selim-drone-proj/fire_detect/hardware/case/drawings/out/png/ESS01-CASE-01_제어함본체.png

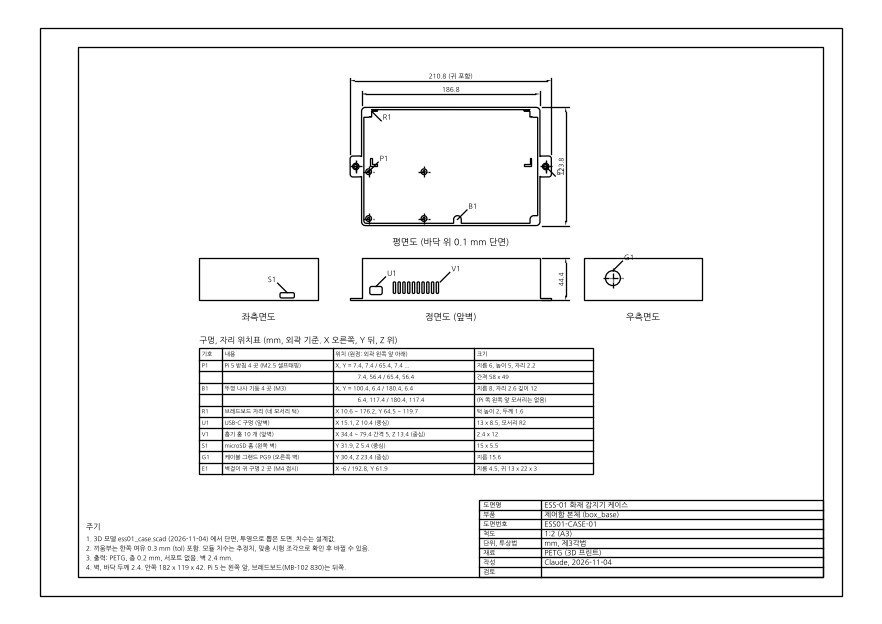
hardware/case/drawings/out/png/ESS01-CASE-01_제어함본체.png
