selim-drone-proj/fire_detect/hardware/case/drawings/out/png/ESS01-CASE-02_제어함뚜껑.png

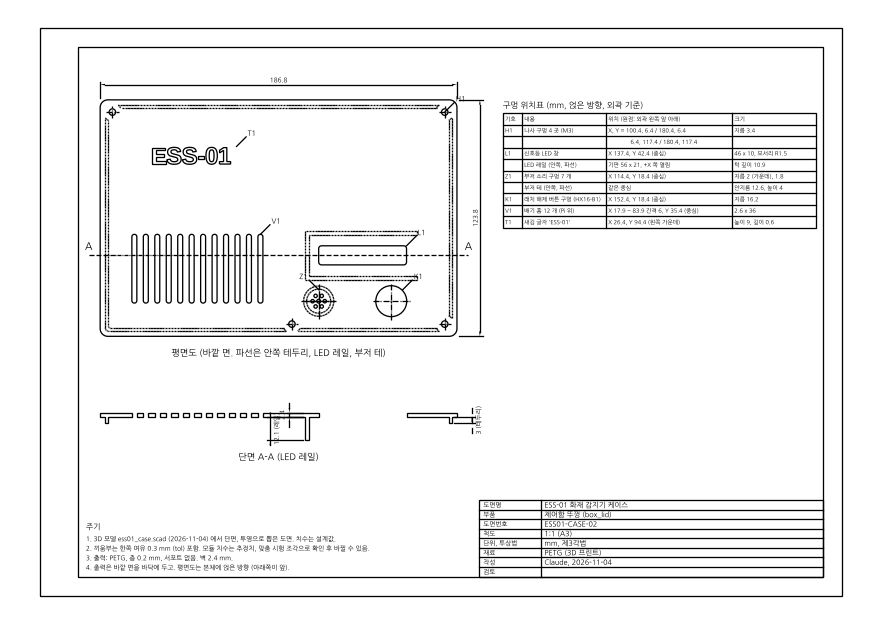
hardware/case/drawings/out/png/ESS01-CASE-02_제어함뚜껑.png
