selim-drone-proj/fire_detect/hardware/case/drawings/out/png/ESS01-CASE-03_센서헤드본체.png

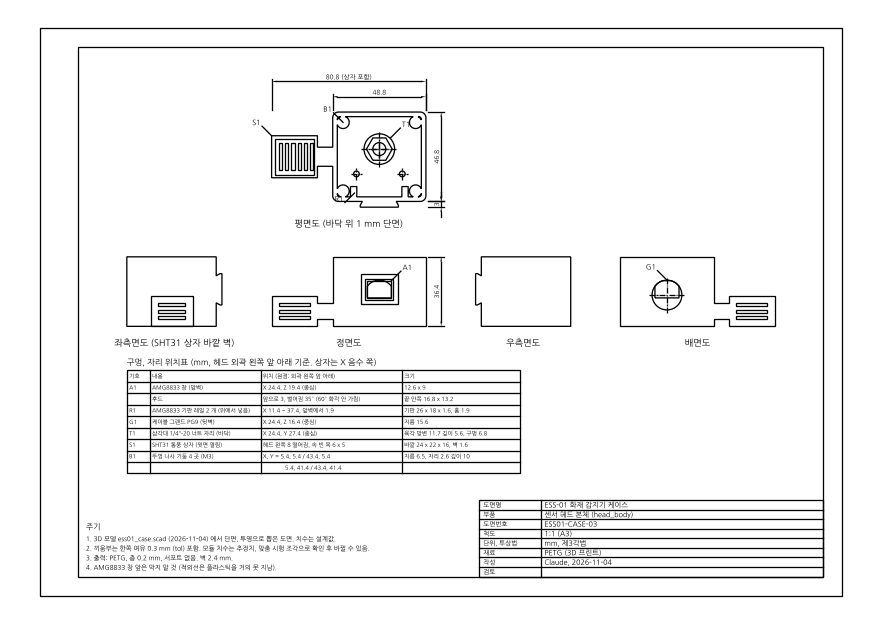
hardware/case/drawings/out/png/ESS01-CASE-03_센서헤드본체.png
