selim-drone-proj/fire_detect/hardware/case/png/base_front.png

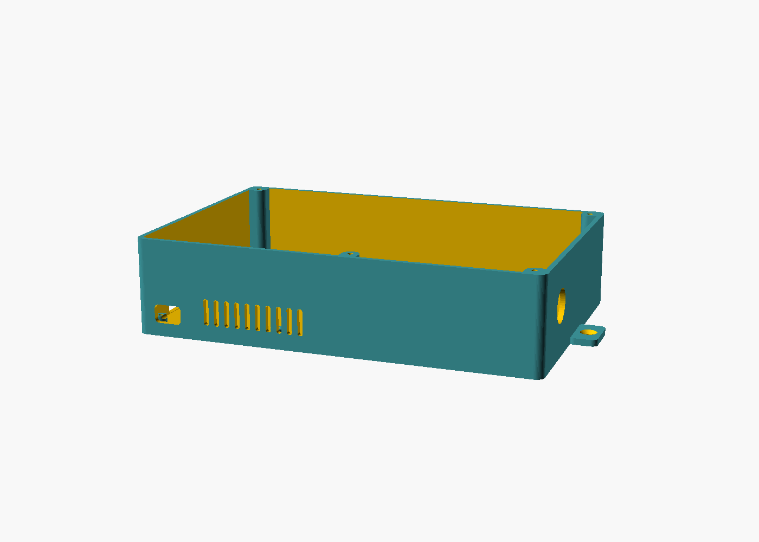
hardware/case/png/base_front.png
