selim-drone-proj/fire_detect/hardware/case/png/base_top.png

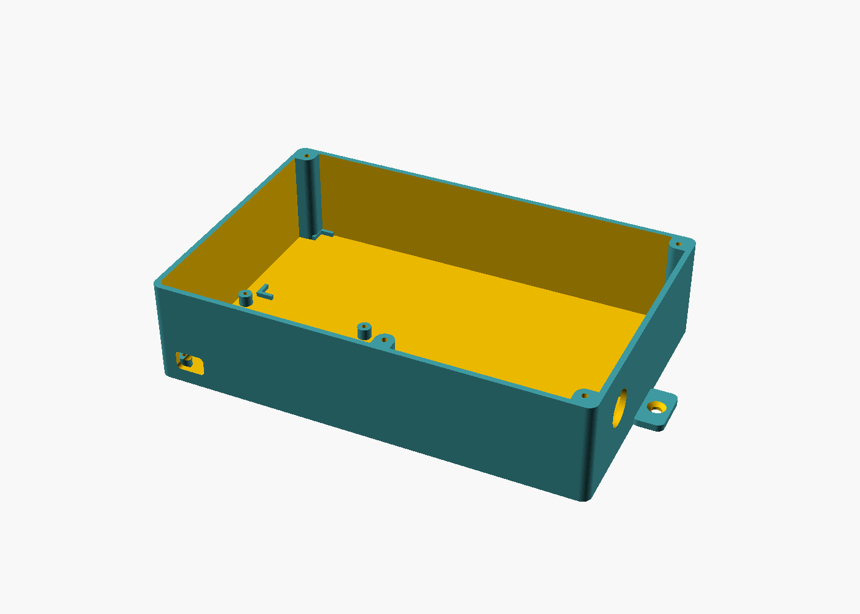
hardware/case/png/base_top.png
