selim-drone-proj/fire_detect/hardware/case/png/head_front.png

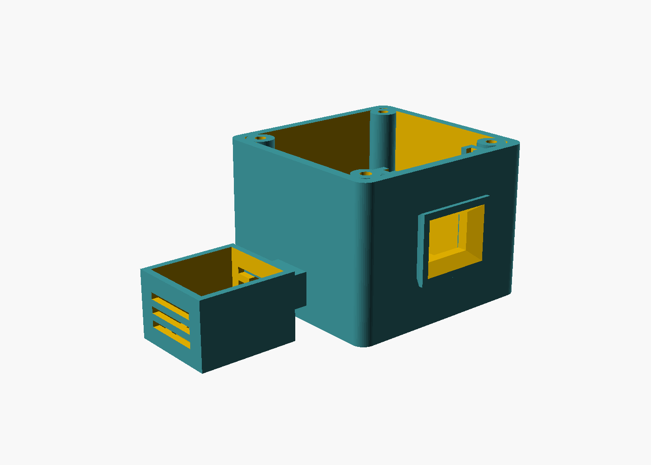
hardware/case/png/head_front.png
