selim-drone-proj/fire_detect/hardware/case/png/head_pod.png

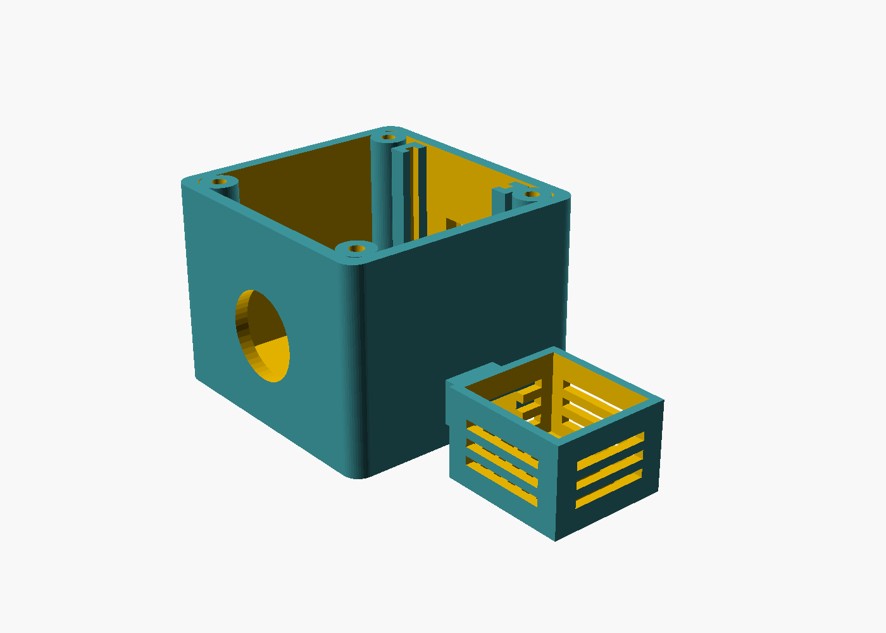
hardware/case/png/head_pod.png
