selim-drone-proj/fire_detect/hardware/case/drawings/out/ESS01-CASE-03_센서헤드본체.dxf

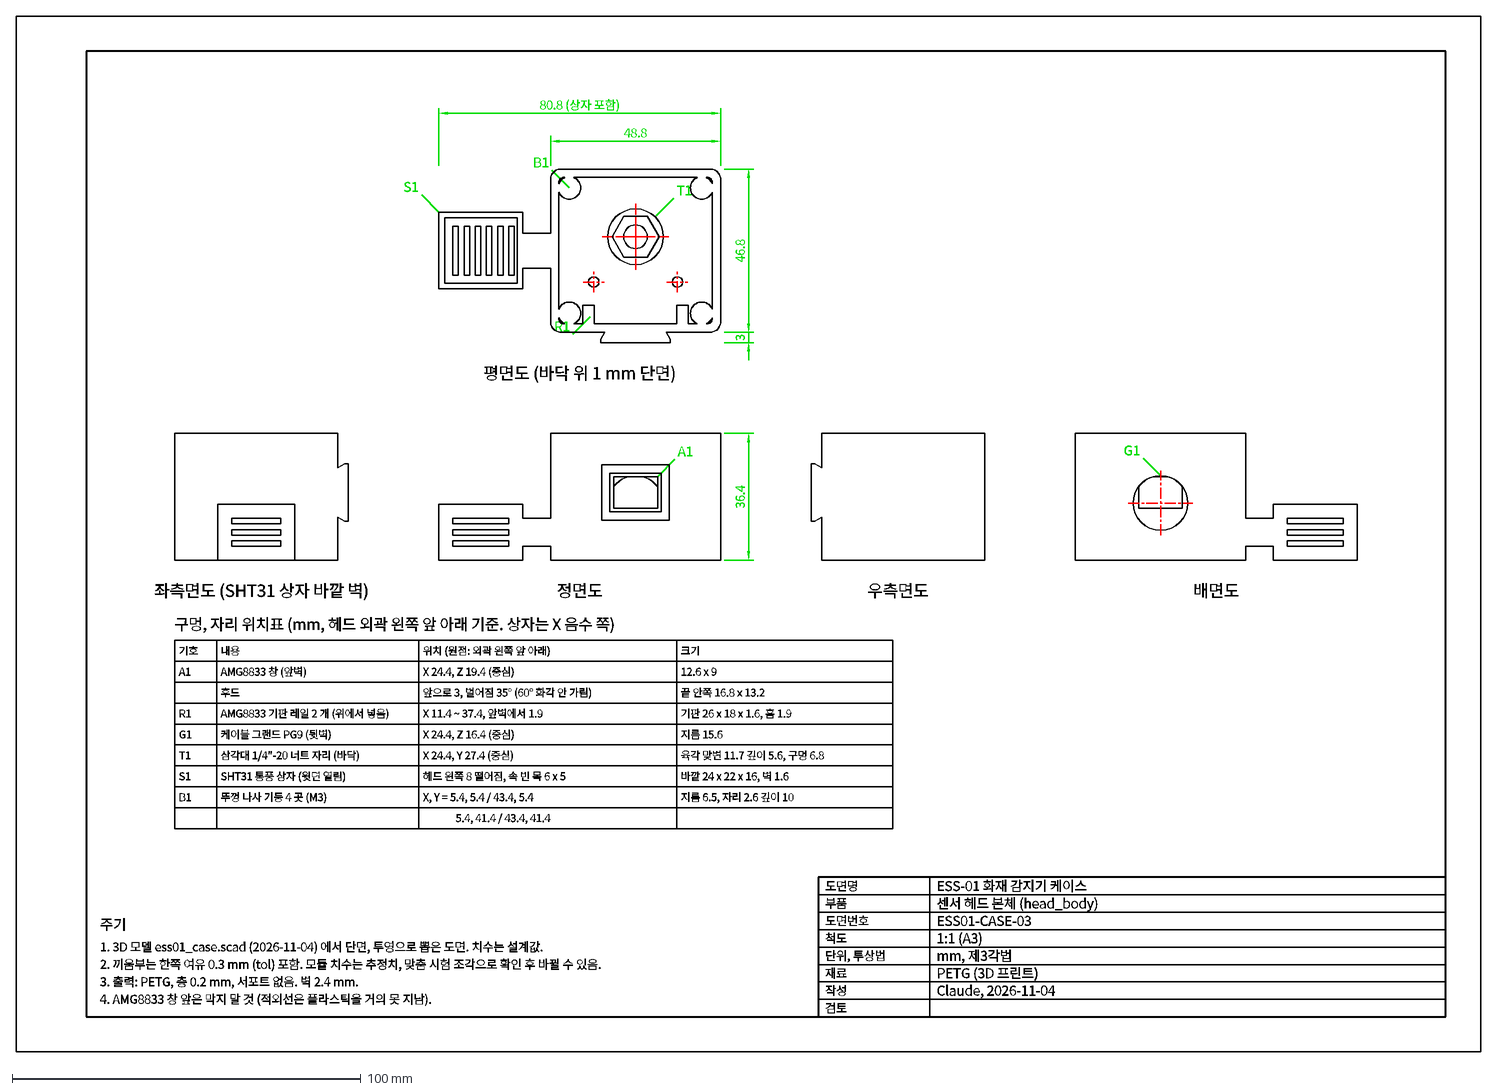
[picture p8: CAD file, 2026-11-07]
hardware/case/drawings/out/ESS01-CASE-03_센서헤드본체.dxf
80.8 (상자 포함)
48.8
46.8
3
36.4
A1
G1
T1
S1
B1
R1
평면도 (바닥 위 1 mm 단면)
정면도
우측면도
좌측면도 (SHT31 상자 바깥 벽)
배면도
구멍, 자리 위치표 (mm, 헤드 외곽 왼쪽 앞 아래 기준. 상자는 X 음수 쪽)
기호
내용
위치 (원점: 외곽 왼쪽 앞 아래)
크기
AMG8833 창 (앞벽)
X 24.4, Z 19.4 (중심)
12.6 x 9
후드
앞으로 3, 벌어짐 35° (60° 화각 안 가림)
끝 안쪽 16.8 x 13.2
AMG8833 기판 레일 2 개 (위에서 넣음)
X 11.4 ~ 37.4, 앞벽에서 1.9
기판 26 x 18 x 1.6, 홈 1.9
케이블 그랜드 PG9 (뒷벽)
X 24.4, Z 16.4 (중심)
지름 15.6
삼각대 1/4"-20 너트 자리 (바닥)
X 24.4, Y 27.4 (중심)
육각 맞변 11.7 깊이 5.6, 구멍 6.8
SHT31 통풍 상자 (윗면 열림)
헤드 왼쪽 8 떨어짐, 속 빈 목 6 x 5
바깥 24 x 22 x 16, 벽 1.6
뚜껑 나사 기둥 4 곳 (M3)
X, Y = 5.4, 5.4 / 43.4, 5.4
지름 6.5, 자리 2.6 깊이 10
5.4, 41.4 / 43.4, 41.4
검토
작성
Claude, 2026-11-04
재료
PETG (3D 프린트)
단위, 투상법
mm, 제3각법
척도
1:1 (A3)
도면번호
ESS01-CASE-03
부품
센서 헤드 본체 (head_body)
도면명
ESS-01 화재 감지기 케이스
4. AMG8833 창 앞은 막지 말 것 (적외선은 플라스틱을 거의 못 지남).
3. 출력: PETG, 층 0.2 mm, 서포트 없음. 벽 2.4 mm.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
