selim-drone-proj/fire_detect/hardware/case/drawings/out/ESS01-CASE-01_제어함본체.dxf

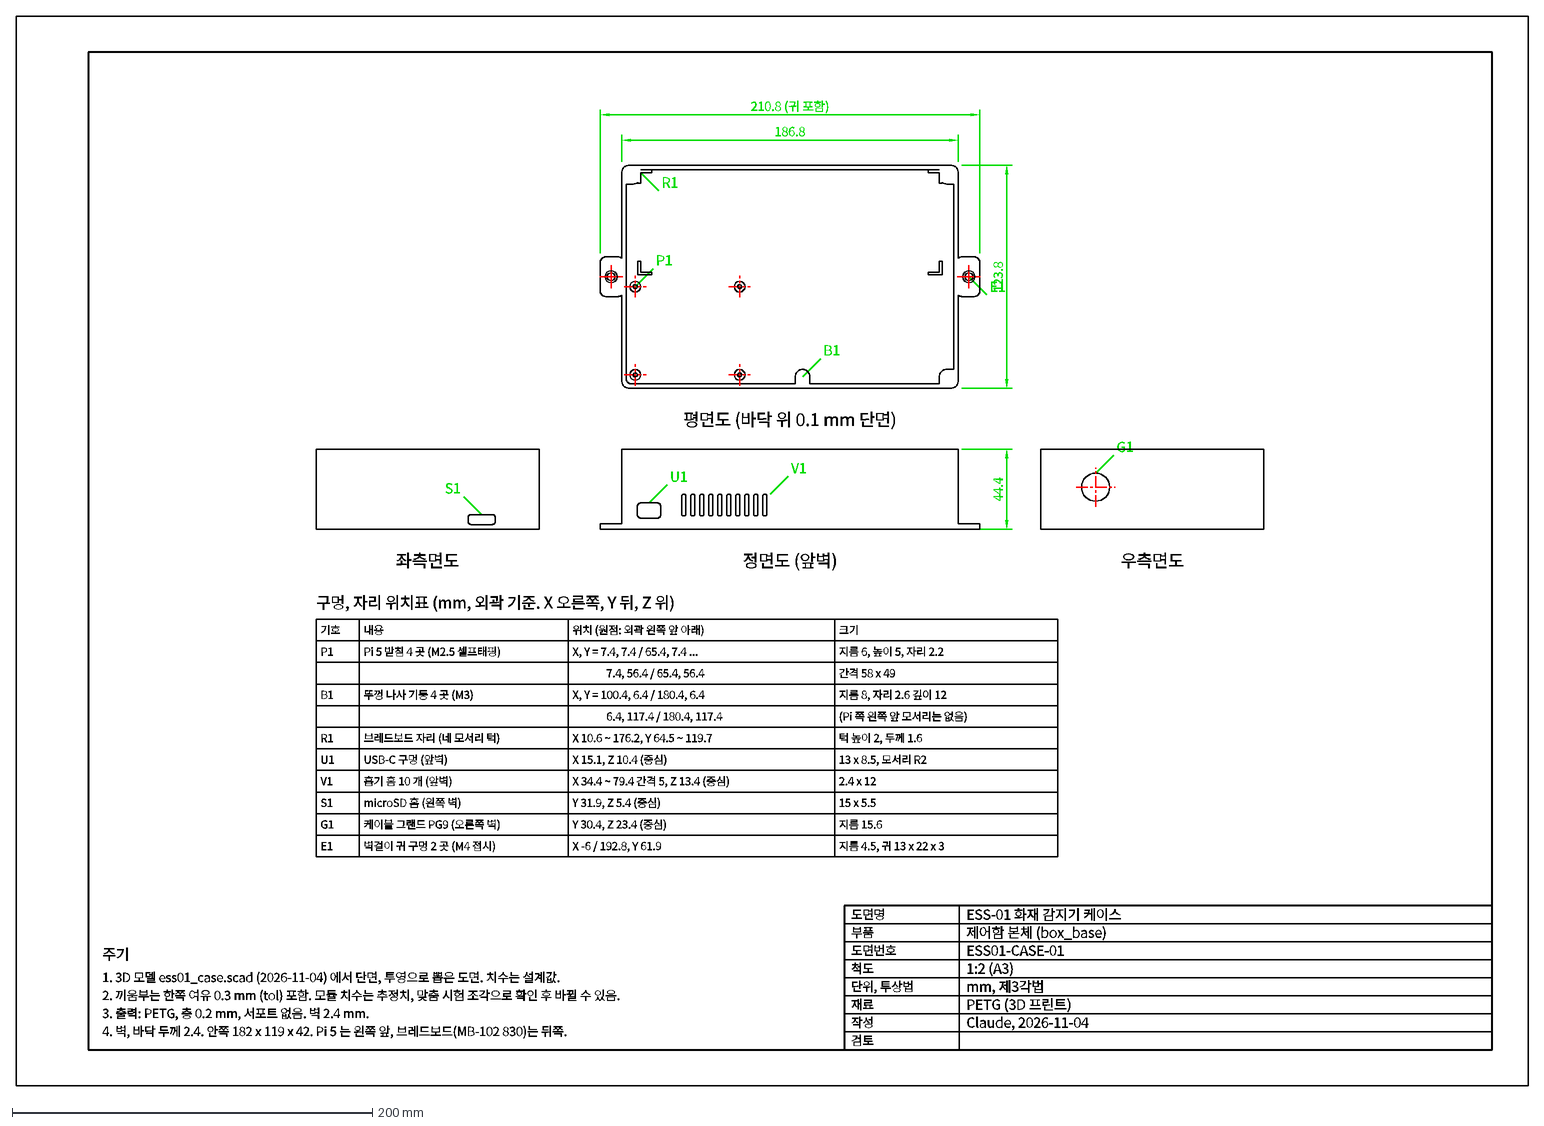
[picture p9: CAD file, 2026-11-07]
hardware/case/drawings/out/ESS01-CASE-01_제어함본체.dxf
186.8
210.8 (귀 포함)
123.8
44.4
P1
B1
R1
E1
U1
V1
S1
G1
평면도 (바닥 위 0.1 mm 단면)
정면도 (앞벽)
우측면도
좌측면도
구멍, 자리 위치표 (mm, 외곽 기준. X 오른쪽, Y 뒤, Z 위)
기호
내용
위치 (원점: 외곽 왼쪽 앞 아래)
크기
Pi 5 받침 4 곳 (M2.5 셀프태핑)
X, Y = 7.4, 7.4 / 65.4, 7.4 ...
지름 6, 높이 5, 자리 2.2
7.4, 56.4 / 65.4, 56.4
간격 58 x 49
뚜껑 나사 기둥 4 곳 (M3)
X, Y = 100.4, 6.4 / 180.4, 6.4
지름 8, 자리 2.6 깊이 12
6.4, 117.4 / 180.4, 117.4
(Pi 쪽 왼쪽 앞 모서리는 없음)
브레드보드 자리 (네 모서리 턱)
X 10.6 ~ 176.2, Y 64.5 ~ 119.7
턱 높이 2, 두께 1.6
USB-C 구멍 (앞벽)
X 15.1, Z 10.4 (중심)
13 x 8.5, 모서리 R2
흡기 홈 10 개 (앞벽)
X 34.4 ~ 79.4 간격 5, Z 13.4 (중심)
2.4 x 12
microSD 홈 (왼쪽 벽)
Y 31.9, Z 5.4 (중심)
15 x 5.5
케이블 그랜드 PG9 (오른쪽 벽)
Y 30.4, Z 23.4 (중심)
지름 15.6
벽걸이 귀 구멍 2 곳 (M4 접시)
X -6 / 192.8, Y 61.9
지름 4.5, 귀 13 x 22 x 3
검토
작성
Claude, 2026-11-04
재료
PETG (3D 프린트)
단위, 투상법
mm, 제3각법
척도
1:2 (A3)
도면번호
ESS01-CASE-01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
