selim-drone-proj/fire_detect/hardware/case/drawings/out/ESS01-CASE-02_제어함뚜껑.dxf

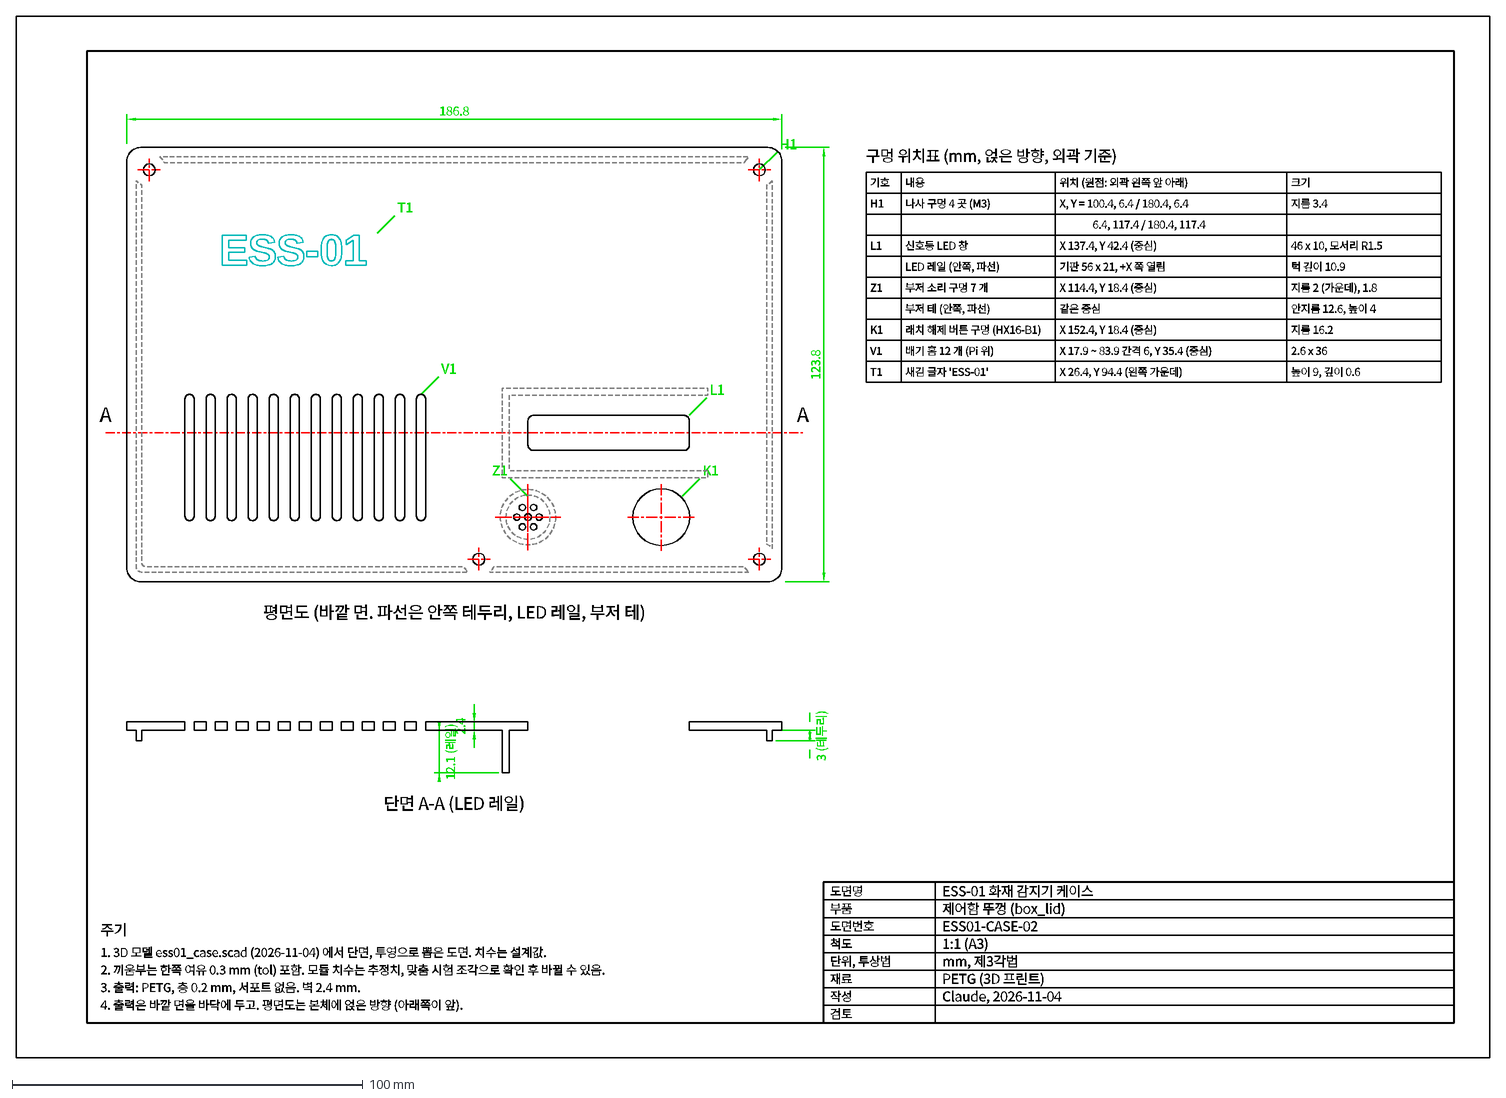
[picture p10: CAD file, 2026-11-07]
hardware/case/drawings/out/ESS01-CASE-02_제어함뚜껑.dxf
A
186.8
123.8
2.4
12.1 (레일)
3 (테두리)
H1
L1
Z1
K1
V1
T1
평면도 (바깥 면. 파선은 안쪽 테두리, LED 레일, 부저 테)
단면 A-A (LED 레일)
구멍 위치표 (mm, 얹은 방향, 외곽 기준)
기호
내용
위치 (원점: 외곽 왼쪽 앞 아래)
크기
나사 구멍 4 곳 (M3)
X, Y = 100.4, 6.4 / 180.4, 6.4
지름 3.4
6.4, 117.4 / 180.4, 117.4
신호등 LED 창
X 137.4, Y 42.4 (중심)
46 x 10, 모서리 R1.5
LED 레일 (안쪽, 파선)
기판 56 x 21, +X 쪽 열림
턱 깊이 10.9
부저 소리 구멍 7 개
X 114.4, Y 18.4 (중심)
지름 2 (가운데), 1.8
부저 테 (안쪽, 파선)
같은 중심
안지름 12.6, 높이 4
래치 해제 버튼 구멍 (HX16-B1)
X 152.4, Y 18.4 (중심)
지름 16.2
배기 홈 12 개 (Pi 위)
X 17.9 ~ 83.9 간격 6, Y 35.4 (중심)
2.6 x 36
새김 글자 'ESS-01'
X 26.4, Y 94.4 (왼쪽 가운데)
높이 9, 깊이 0.6
검토
작성
Claude, 2026-11-04
재료
PETG (3D 프린트)
단위, 투상법
mm, 제3각법
척도
1:1 (A3)
도면번호
ESS01-CASE-02
부품
제어함 뚜껑 (box_lid)
도면명
ESS-01 화재 감지기 케이스
4. 출력은 바깥 면을 바닥에 두고. 평면도는 본체에 얹은 방향 (아래쪽이 앞).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
