selim-drone-proj/fire_detect/hardware/case/png/assembly_top.png

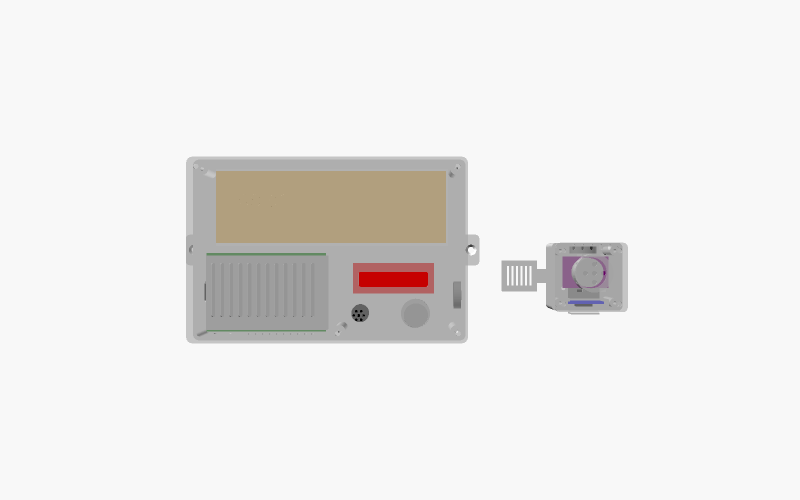
hardware/case/png/assembly_top.png
