selim-drone-proj/fire_detect/hardware/case/png/fit_test.png

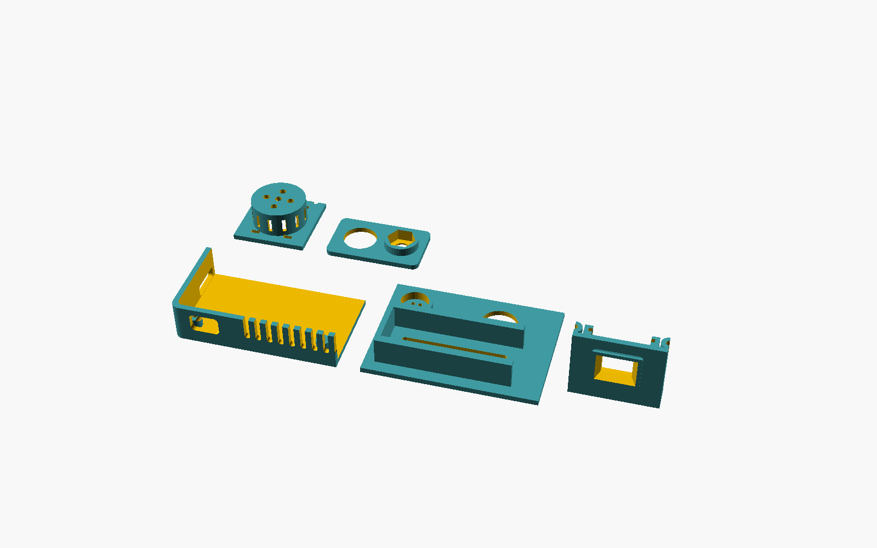
hardware/case/png/fit_test.png
