selim-drone-proj/fire_detect/(commit log)

2026-10-10 화재 감지기 (ess_01) 소프트웨어 첫 업로드
    - fire_detect: AMG8833 열화상, SHT31 주변 온도, MQ-2 연기 (ADS1115) 로 1초마다 판정
    - 위험하면 SSR 과 릴레이로 충전 차단, 부저와 신호등 LED, OLED 표시
    - 기록: fire, thermal CSV 와 규격 v0.2 JSONL, 선택적으로 ROS 2 전송
    - systemd 서비스 (watchdog), 하드웨어 없이 도는 시뮬레이션 (--simulate)
    - 시험: 24 통과
    Claude-Session: https://claude.ai/code/session_012wNjCpgR12iZANsGPh38N5
2026-10-10 LICENSE 추가 (Apache-2.0, moving-ver 와 stable-ver 와 같은 문서)
    pyproject.toml 의 license 표기와 맞춤. 다른 라이선스를 쓸 거면 이 커밋만 빼면 됨.
    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
2026-10-10 보드 세팅용 CLAUDE.md 와 부품 점검 도구 hw_check.py 추가
    - CLAUDE.md: 보드 위 Claude Code 가 따를 안전 규칙(SSR AC 분리 확인 전 출력 시험 금지,
    시스템 파일 변경 전 확인과 .bak, 판정 기준과 watchdog 변경 금지, push 금지 등),
    핀과 주소 표, 14 단계 세팅 순서, 자주 걸리는 것
    - tools/hw_check.py: i2c, sensors, outputs, button 점검. outputs 는 'AC 분리' 입력 뒤에만
    위험이 적은 순서로 하나씩 켜고, 끝나거나 오류가 나도 모두 끈다. 서비스가 돌면 시작하지 않음
    - tests/test_hw_check.py: 가짜 하드웨어로 6 개 (전체 30 통과)
    - README: 3장 점검 명령, 6장 시험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
2026-10-10 CLAUDE.md: git 은 PR 까지 자동, 병합은 사람 (개인 토큰 인증 절차 추가)
    - 안전 규칙 6: 저장소를 고치면 새 브랜치에 커밋, push 하고 PR 을 연다.
    승인, 병합, main 직접 push, force push, 브랜치 삭제, 저장소 설정은 사람이 한다
    - 'git 과 PR' 절: 브랜치 이름, 시험 통과 뒤 커밋, gh pr create, 쓰지 않을 명령, 토큰을 보여 주는 명령 금지
    - 'GitHub 인증' 절: fine-grained 개인 토큰(fire_detect, Contents 와 Pull requests 읽기 쓰기),
    gh auth login 과 gh auth setup-git, main 보호 규칙 권장
    - 마무리 보고에 PR 주소 포함
    Claude-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
2026-11-04 화재 감지기 케이스 3D 프린트 파일 (보조배터리 벤치 구성)
    보조배터리 벤치 구성용 케이스를 제어함과 센서 헤드로 나눠 OpenSCAD 파라메트릭으로 설계했다.
    - 제어함: Pi 5 (받침 M2.5, 앞벽 USB-C, 왼쪽 벽 microSD), 풀 브레드보드 MB-102 자리, 앞벽 흡기, 뚜껑 배기,
    뚜껑에 신호등 LED 창과 레일, 부저 테, 래치 해제 버튼 16 mm 구멍, PG9 그랜드, 벽걸이 귀
    - 센서 헤드: AMG8833 레일과 막히지 않는 창, 35° 후드 (60° 화각), MQ-2 뚜껑 구멍과 보호 캡,
    SHT31 을 MQ-2 열에서 떨어뜨린 통풍 상자, 삼각대 1/4" 너트 자리, PG9 그랜드
    - 맞춤 시험 조각: 실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
2026-11-04 케이스 2D 도면 DXF 4 장 (평면도, 정면도, 측면도, 위치표)과 A3 PDF
    3D 모델을 OpenSCAD 로 단면, 투영해 부품별 도면을 뽑고 ezdxf 로 도면틀, 제3각법 배치, 치수, 위치표를 넣었다.
    - ESS01-CASE-01 제어함 본체 1:2, -02 뚜껑 1:1 (안쪽 레일 파선, 단면 A-A), -03 센서 헤드 1:1, -04 헤드 뚜껑 2:1
    - DXF R2013, mm, 레이어 OUTLINE, HIDDEN, CENTER, DIM, TEXT, FRAME, CUTLINE, ENGRAVE. 한글 문자 스타일 KOR (malgun.ttf)
    - 구멍, 자리는 기호와 위치표 (외곽 왼쪽 앞 아래 기준). 위치표 값은 scad 변수에서 계산하고,
    모델 단면에서 구멍 중심을 직접 재 22 곳 대조해 모두 일치
    - dr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
